Sandmann21s/krux/Mod_Case_Yahaboom/Captura de tela 2024-10-02 151728.png

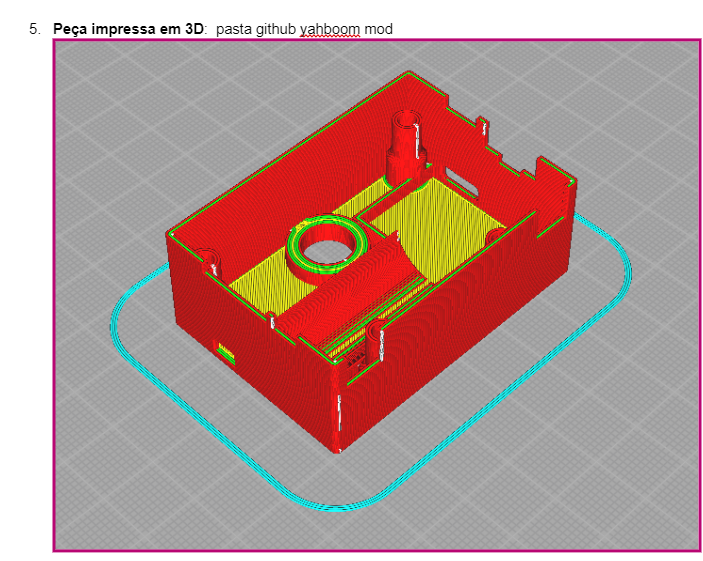
Mod_Case_Yahaboom/Captura de tela 2024-10-02 151728.png
