Sandmann21s/krux/Mod_Case_Yahaboom/Mont1.SLDASM

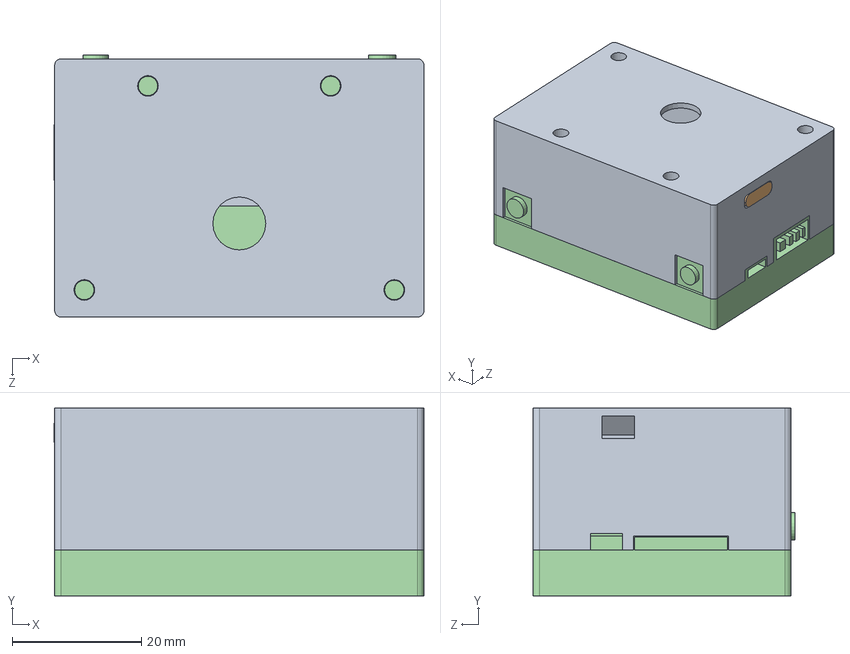
[picture p14: CAD file, 2024-10-02]
Mod_Case_Yahaboom/Mont1.SLDASM
57.3 x 29.1 x 40.6 mm
modulo
bateria
placa bateria
case
