Sandmann21s/krux/Mod_Case_Yahaboom/modulo.SLDPRT

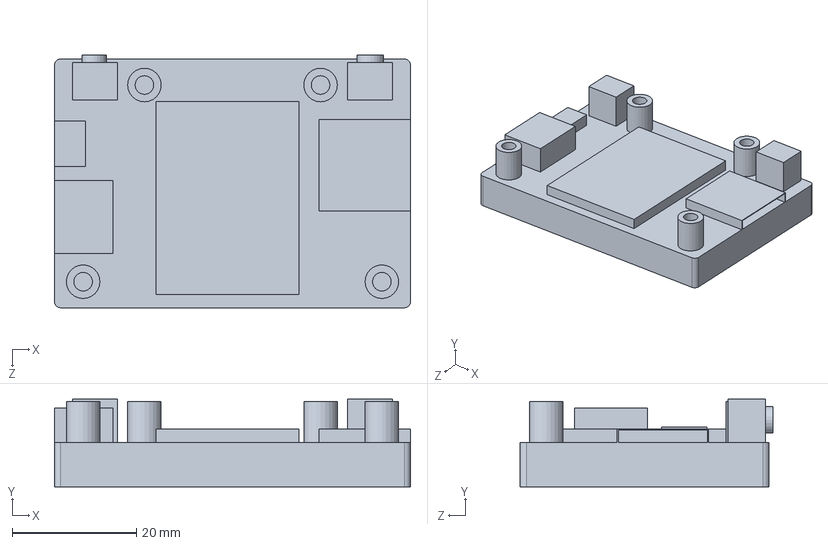
[picture p15: CAD file, 2024-10-02]
Mod_Case_Yahaboom/modulo.SLDPRT
57.2 x 14.1 x 40.6 mm
