Sandmann21s/krux/Mod_Case_Yahaboom/placa bateria.SLDPRT

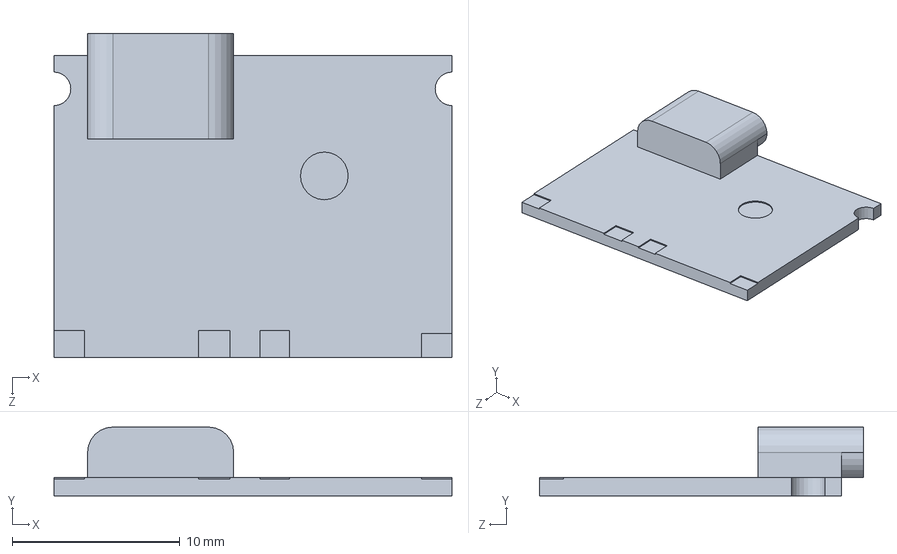
[picture p16: CAD file, 2024-10-02]
Mod_Case_Yahaboom/placa bateria.SLDPRT
23.7 x 4.10 x 19.3 mm
