Sandmann21s/krux/Mod_Case_Yahaboom/case.SLDPRT

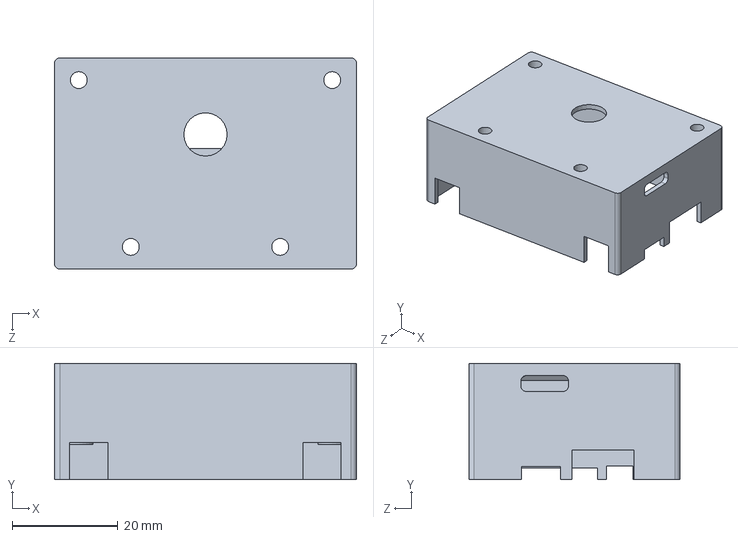
[picture p17: CAD file, 2024-10-02]
Mod_Case_Yahaboom/case.SLDPRT
57.2 x 22.0 x 40.0 mm
