Sandmann21s/krux/Mod_Case_Yahaboom/bateria.SLDPRT

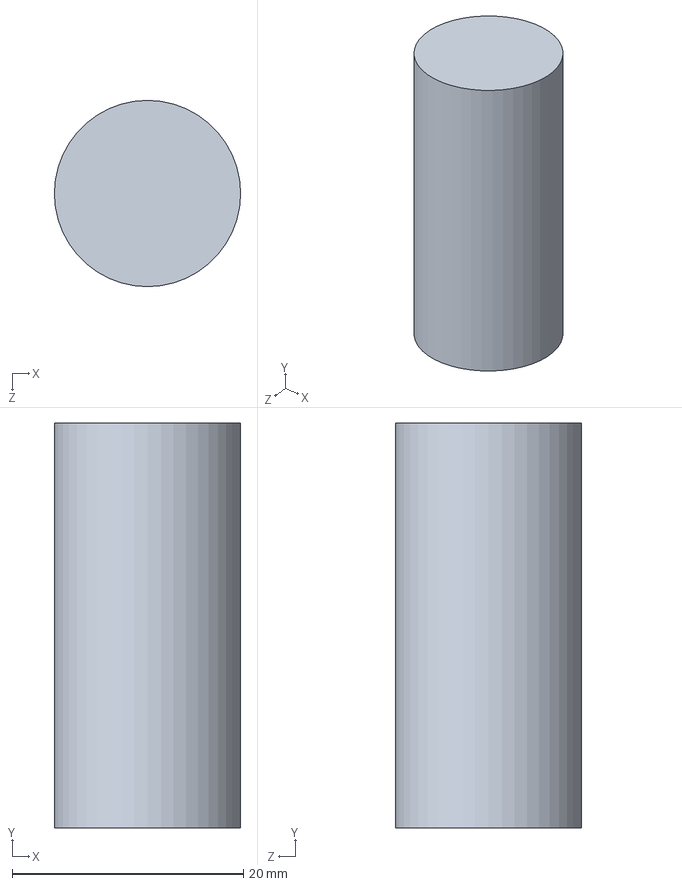
[picture p18: CAD file, 2024-10-02]
Mod_Case_Yahaboom/bateria.SLDPRT
16.1 x 35.0 x 16.1 mm
