Sandmann21s/krux/(list of files, cad)

Other CAD files:
Mod_Case_Yahaboom/case.STL
